kamilix2003/Band-pass-project/418358178_380706147782730_8515125975770715655_n.jpg

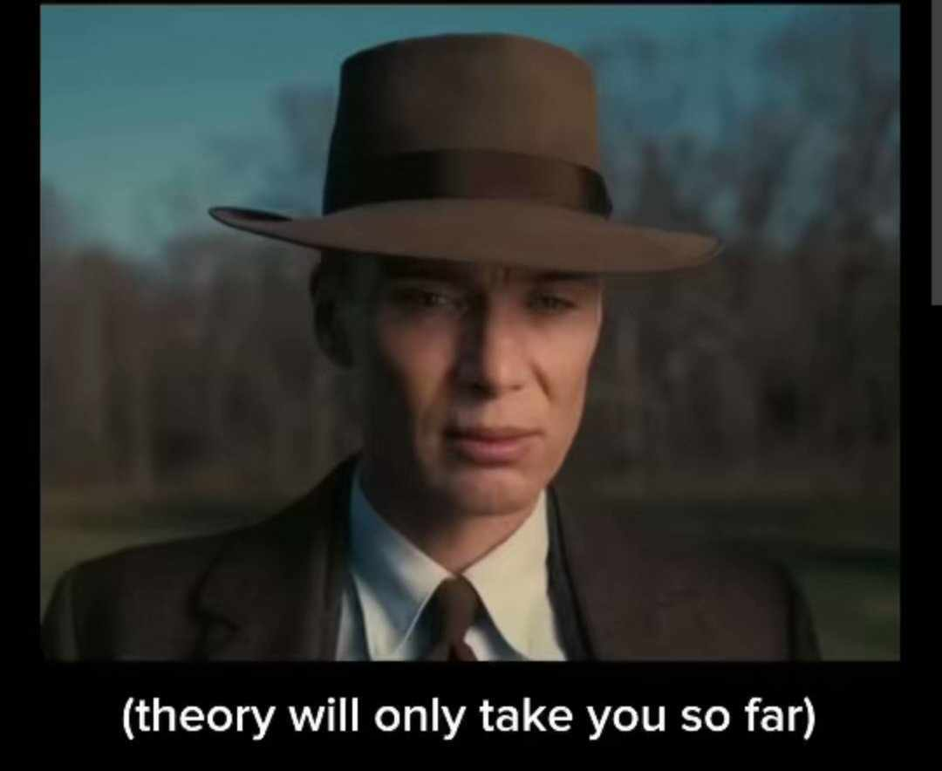
418358178_380706147782730_8515125975770715655_n.jpg
