kamilix2003/Band-pass-project/osc/RigolDS0.png

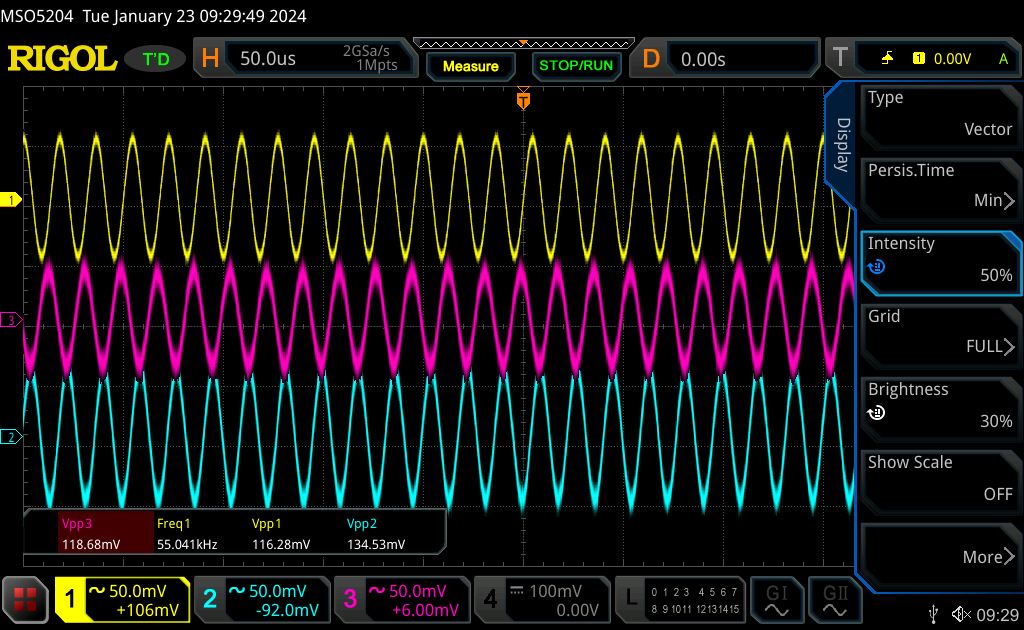
osc/RigolDS0.png
