kamilix2003/Band-pass-project/README.md

# Band-pass-project
Analogue Elelctronic Circuits I final project, op-amp based second order band pass filter with uni-polar power supply

[Project report](report.pdf)
