kamilix2003/Band-pass-project/filter-design-report-8.pdf

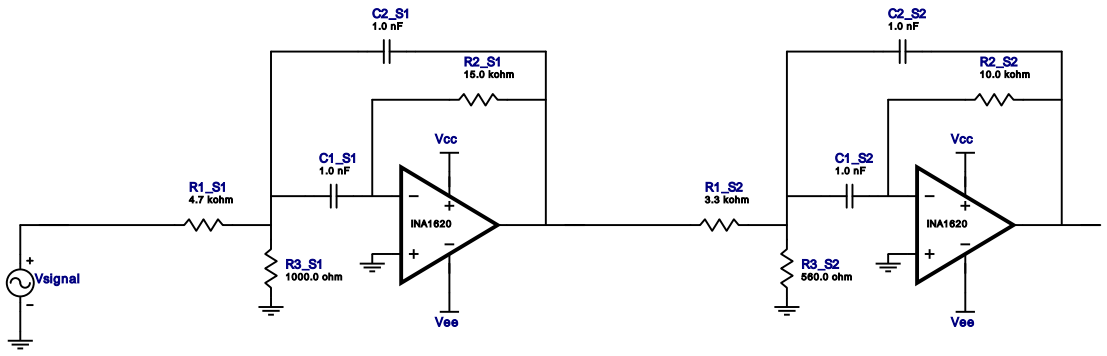
[picture p6: figure]
Vsignal; INA1620; R1_S1 4.7 kohm; R2_S1 15.0 kohm; R3_S1 1000.0 ohm; Vcc; Vee; R1_S2 3.3 kohm; R2_S2 10.0 kohm; R3_S2 560.0 ohm

Copyright © 2024, Texas Instruments Incorporated | 1
Filter Design Report | Bandpass Filter - 4th order Butterworth | January 16, 2024 07:32:41 GMT-06:00

## Filter Design Report

Design : Bandpass Filter - 4th order Butterworth Design ID: 8

Type : Bandpass
Response : Butterworth
Order : 4
Number of Stages : 2

## Electrical BOM

# Name | Manufacturer | Part Number | Properties | Qty

1. A1_S1 | Texas Instruments Inc. | INA1620 | GbwTyp= 32MHz VccMax= 36V VccMin= 4V | 1
2. A1_S2 | Texas Instruments Inc. | INA1620 | GbwTyp= 32MHz VccMax= 36V VccMin= 4V

1

3. C1_S1 | Generic | Ideal | Cap= 1.0 nF Tolerance= 2.0 %

1

4. C1_S2 | Generic | Ideal | Cap= 1.0 nF Tolerance= 2.0 %

1

5. C2_S1 | Generic | Ideal | Cap= 1.0 nF Tolerance= 2.0 %

1

6. C2_S2 | Generic | Ideal | Cap= 1.0 nF Tolerance= 2.0 %

1

7. R1_S1 | Generic | Ideal | Res= 4700.0ohm Tolerance= 10%

1

8. R1_S2 | Generic | Ideal | Res= 3300.0ohm Tolerance= 10%

1

9. R2_S1 | Generic | Ideal | Res= 15000.0ohm Tolerance= 10%

1

10. R2_S2 | Generic | Ideal | Res= 10000.0ohm Tolerance= 10%

1

11. R3_S1 | Generic | Ideal | Res= 1000.0ohm Tolerance= 10%

1

12. R3_S2 | Generic | Ideal | Res= 560.0ohm Tolerance= 10%

1

## Sensitivity Analysis

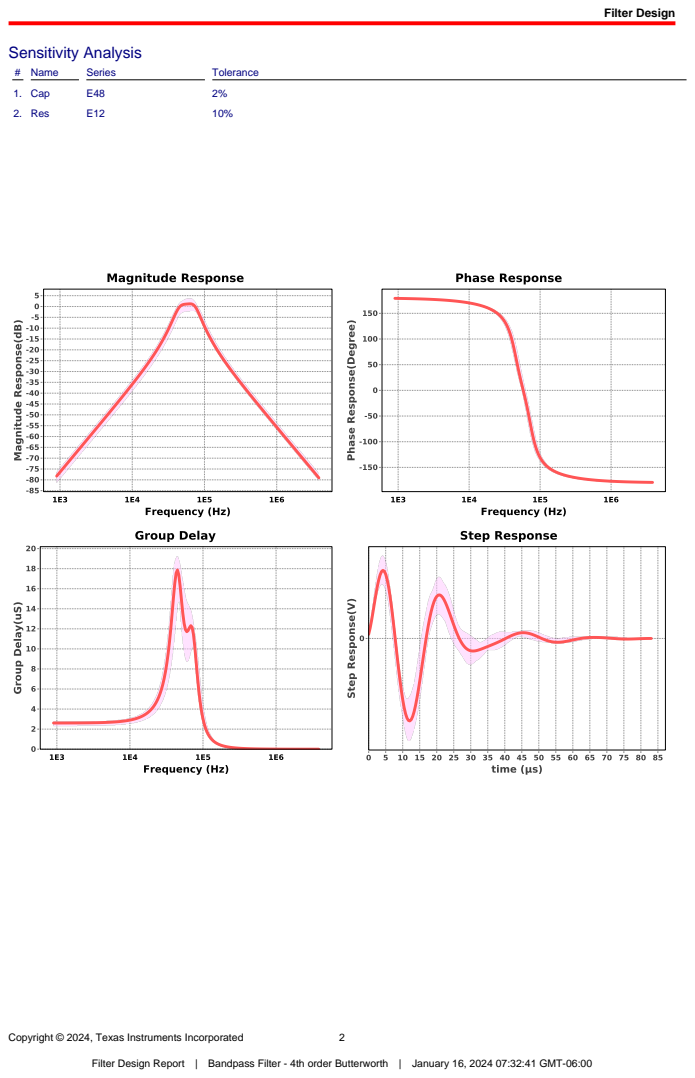
[picture p7: page 2]
Filter Design; # Name; Series; Tolerance; 1. Cap; 2. Res

## Design Inputs

# | Name | Value | Description

1. FilterType | bandpass
2. FilterResponse | Butterworth
3. FilterOrder | 4.0
4. FilterTopology | Multiple Feedback
5. NumberOfStages | 2.0
6. CenterFrequency | 60.0 k
7. StopbandAttenuation | -40.001
8. PassbandBandwidth | 40.0 k
9. StopbandBandwidth | 400.0 k
10. Gain | 1.0
11. SingleSupply | 15.0 | Power supply(s) to active chips
12. ResistorTolerance | E12 | Resistor series - 10% Passive resistor tolerance
13. CapacitorTolerance | E48 | Capacitor series - 2% Passive capacitor tolerance

## Design Assistance

1. INA1620 Product Folder : http://www.ti.com/product/INA1620 : contains the data sheet and other resources.

# Filter Stage :1

Cutoff Frequency | 45.255 kHz
Min GBW Reqd | 14.992 MHz
Stage Gain | 1.596 V/V
Stage Q | 2.133
Stage Topology | Multiple Feedback

C2_S1
1.0 nF

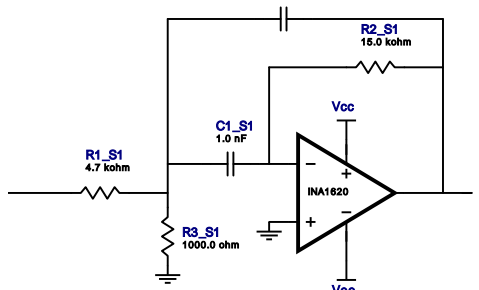
[picture p8: figure]
INA1620; R1_S1 4.7 kohm; R2_S1 15.0 kohm; R3_S1 1000.0 ohm; Vcc

Vee

## Electrical BOM

# Name | Manufacturer | Part Number | Properties | Qty

1. A1_S1 | Texas Instruments Inc. | INA1620 | GbwTyp= 32MHz VccMax= 36V VccMin= 4V | 1
2. C1_S1 | Generic | Ideal | Cap= 1.0 nF Tolerance= 2.0 %

1

3. C2_S1 | Generic | Ideal | Cap= 1.0 nF Tolerance= 2.0 %

1

4. R1_S1 | Generic | Ideal | Res= 4700.0ohm Tolerance= 10%

1

5. R2_S1 | Generic | Ideal | Res= 15000.0ohm Tolerance= 10%

1

6. R3_S1 | Generic | Ideal | Res= 1000.0ohm Tolerance= 10%

1

# Filter Stage :2

Cutoff Frequency | 72.738 kHz
Min GBW Reqd | 24.22 MHz
Stage Gain | 1.515 V/V
Stage Q | 2.285
Stage Topology | Multiple Feedback

C2_S2
1.0 nF

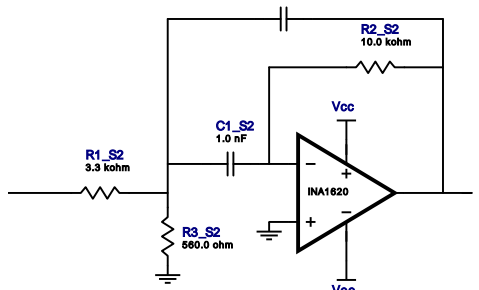
[picture p9: figure]
INA1620; R1_S2 3.3 kohm; R2_S2 10.0 kohm; R3_S2 560.0 ohm; Vcc

Vee

## Electrical BOM

# Name | Manufacturer | Part Number | Properties | Qty

1. A1_S2 | Texas Instruments Inc. | INA1620 | GbwTyp= 32MHz VccMax= 36V VccMin= 4V | 1
2. C1_S2 | Generic | Ideal | Cap= 1.0 nF Tolerance= 2.0 %

1

3. C2_S2 | Generic | Ideal | Cap= 1.0 nF Tolerance= 2.0 %

1

4. R1_S2 | Generic | Ideal | Res= 3300.0ohm Tolerance= 10%

1

5. R2_S2 | Generic | Ideal | Res= 10000.0ohm Tolerance= 10%

1

6. R3_S2 | Generic | Ideal | Res= 560.0ohm Tolerance= 10%

1

Important Notice and Disclaimer

TI provides technical and reliability data (including datasheets), design resources (including reference designs), application or other design advice, web tools, safety information, and other resources AS IS and with all faults, and disclaims all warranties. These resources are intended for skilled developers designing with TI products. You are solely responsible for (1) selecting the appropriate TI products for your application, (2) designing, validating and testing your application, and (3) ensuring your application meets applicable standards, and any other safety, security, or other requirements.

These resources are subject to change without notice. TI grants you permission to use these resources only for development of an application that uses the TI products described in the resource. Other reproduction and display of these resources is prohibited. No license is granted to any other TI intellectual property right or to any third party intellectual property right. TI disclaims responsibility for, and you will fully indemnify TI and its representatives against, any claims, damages, costs, losses, and liabilities arising out of your use of these resources.

Providing these resources does not expand or otherwise alter TI's applicable Terms of Sale or other applicable terms available either on ti.com or provided in conjunction with TI products.
