kamilix2003/Band-pass-project/osc/RigolDS2.png

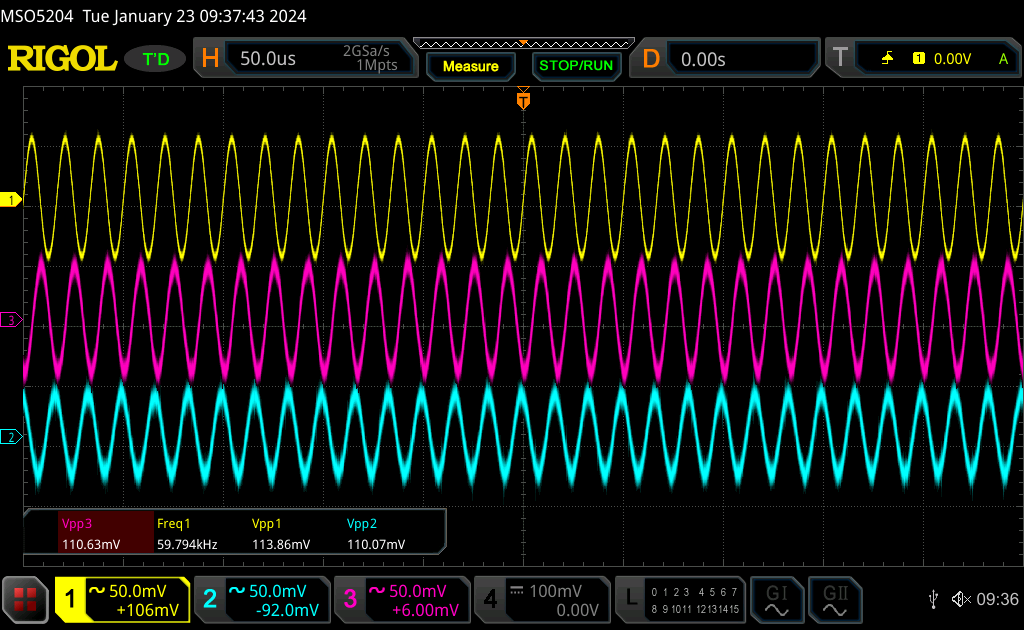
osc/RigolDS2.png
