kamilix2003/Band-pass-project/osc/RigolDS3.png

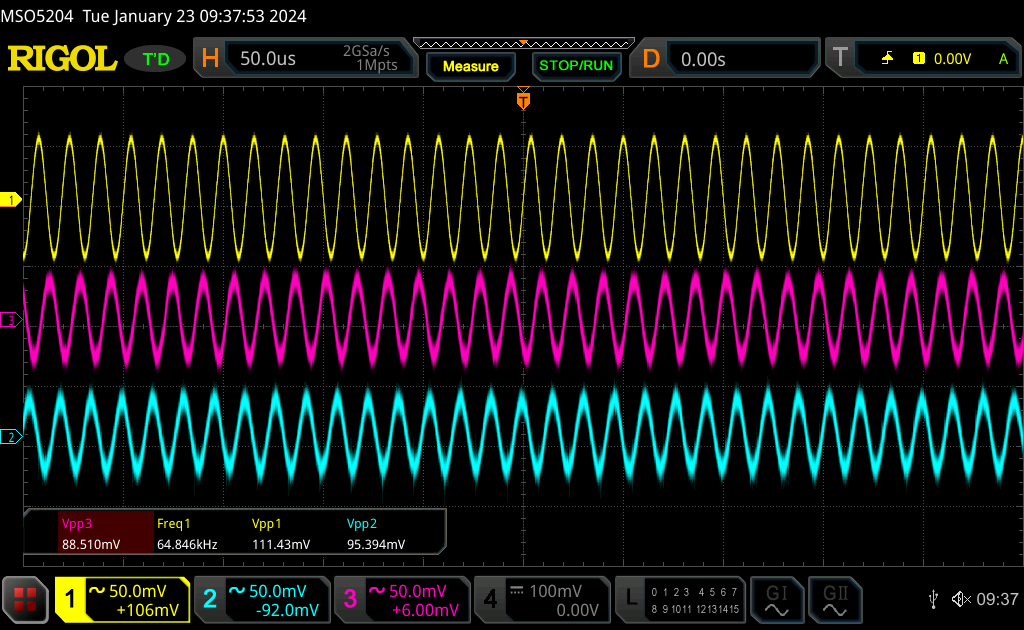
osc/RigolDS3.png
