kamilix2003/Band-pass-project/osc/RigolDS4.png

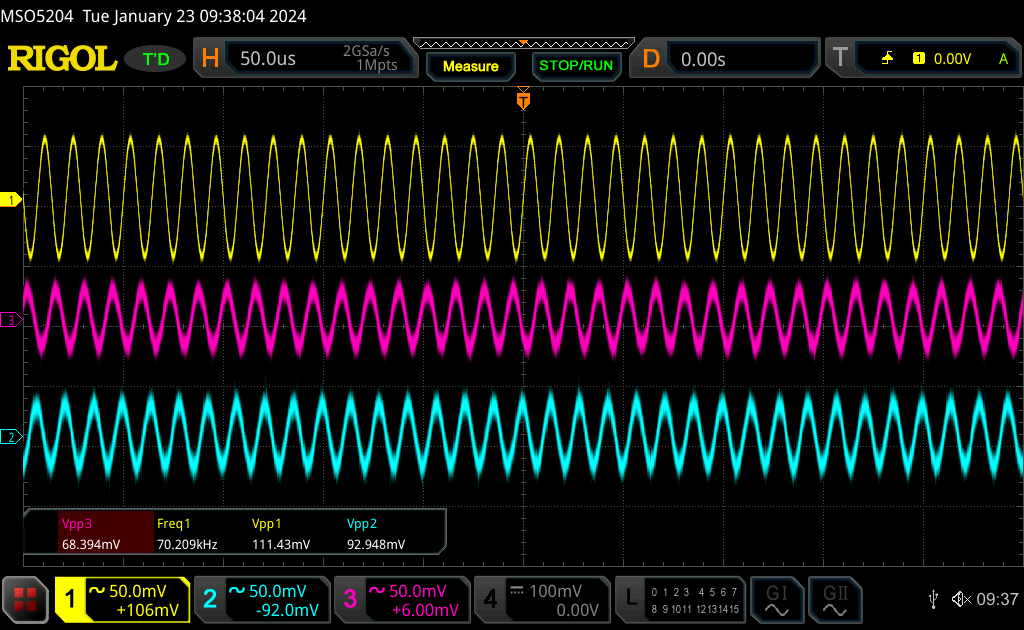
osc/RigolDS4.png
