kamilix2003/Band-pass-project/osc/RigolDS5.png

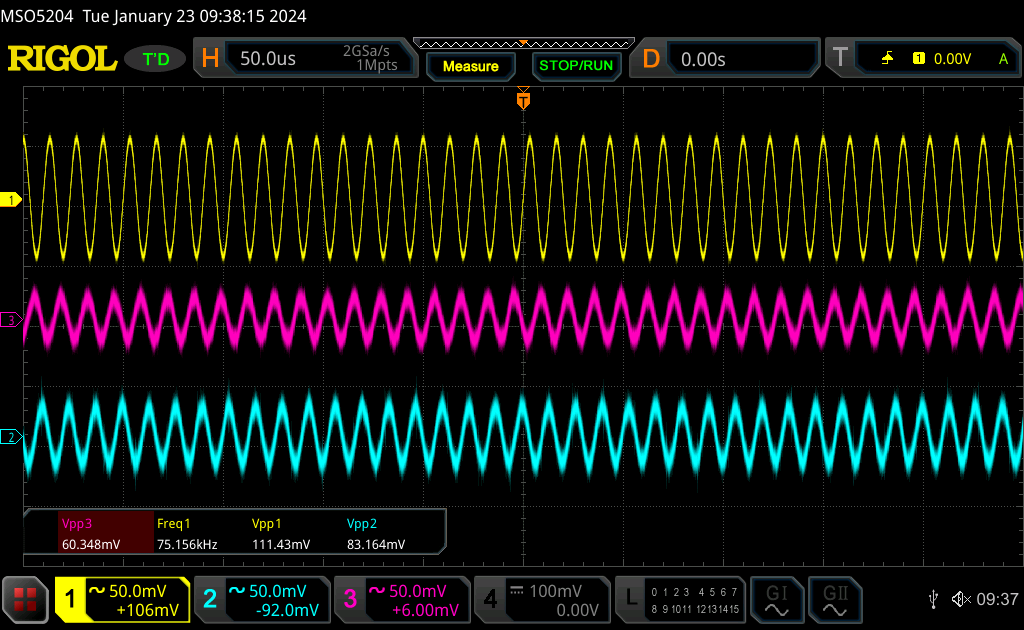
osc/RigolDS5.png
