kamilix2003/Band-pass-project/osc/RigolDS6.png

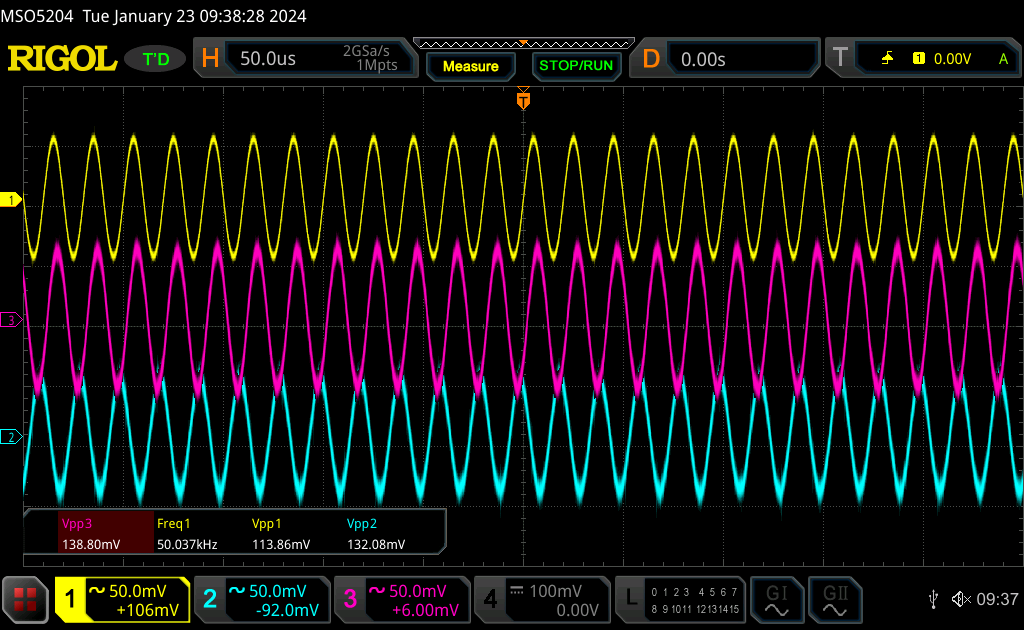
osc/RigolDS6.png
