kamilix2003/Band-pass-project/osc/RigolDS7.png

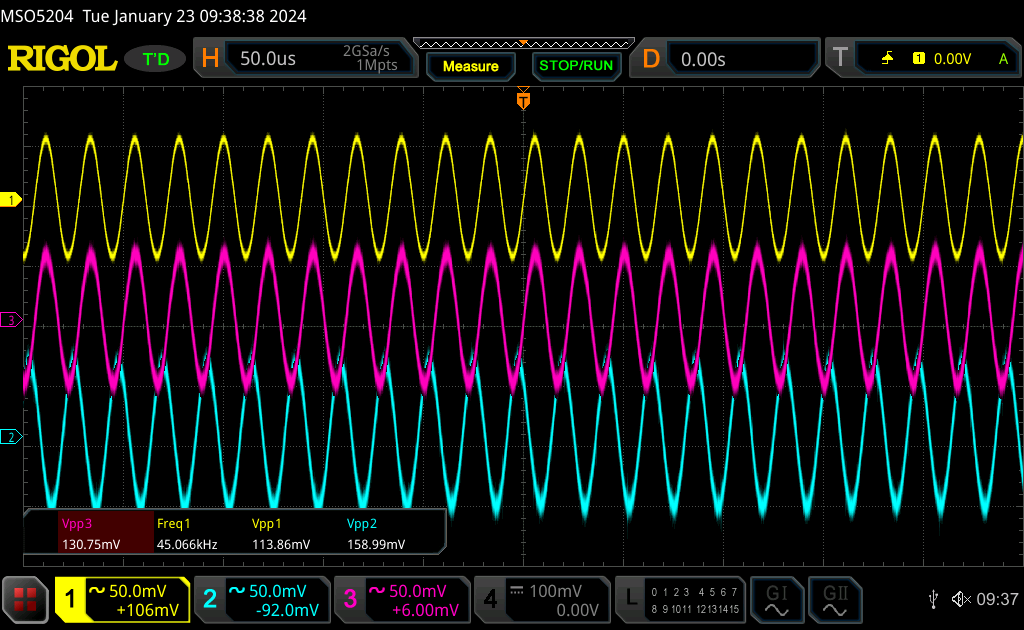
osc/RigolDS7.png
