kamilix2003/Band-pass-project/osc/RigolDS8.png

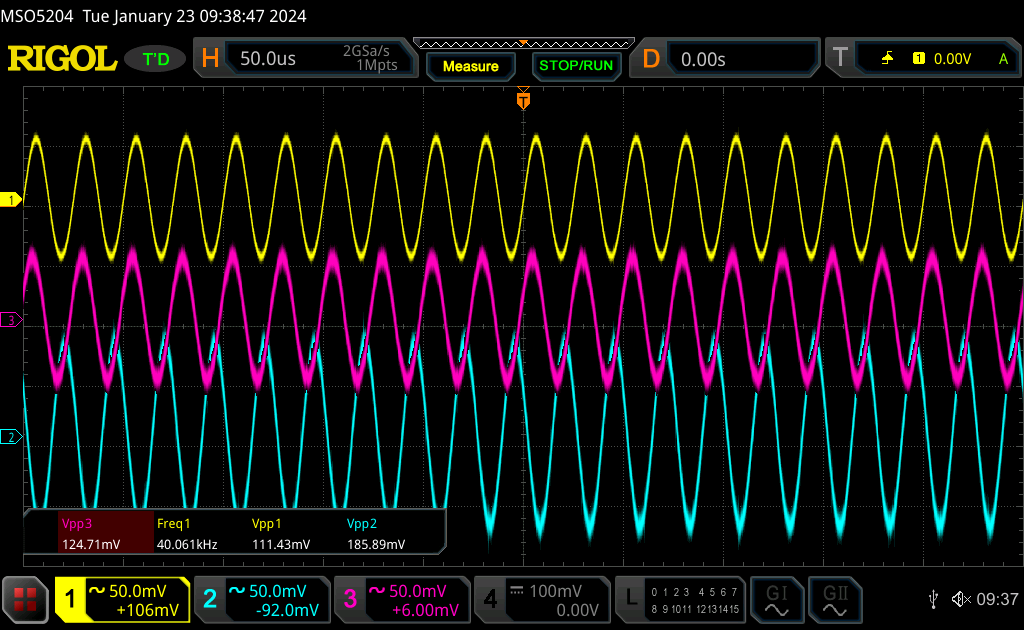
osc/RigolDS8.png
