kamilix2003/Band-pass-project/osc/RigolDS9.png

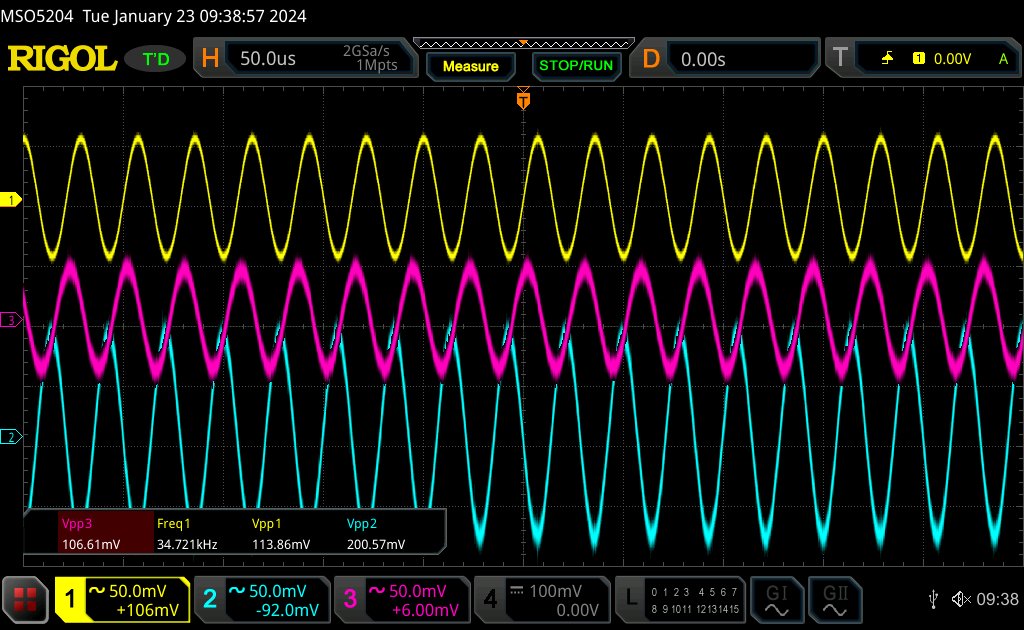
osc/RigolDS9.png
