kamilix2003/Band-pass-project/osc/RigolDS10.png

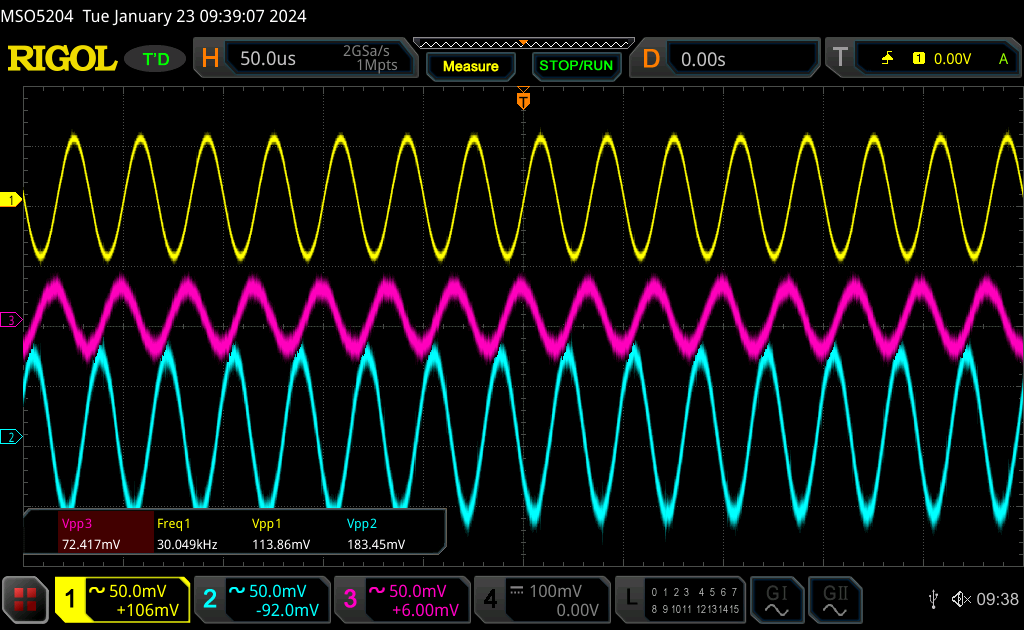
osc/RigolDS10.png
