kamilix2003/Band-pass-project/osc/RigolDS11.png

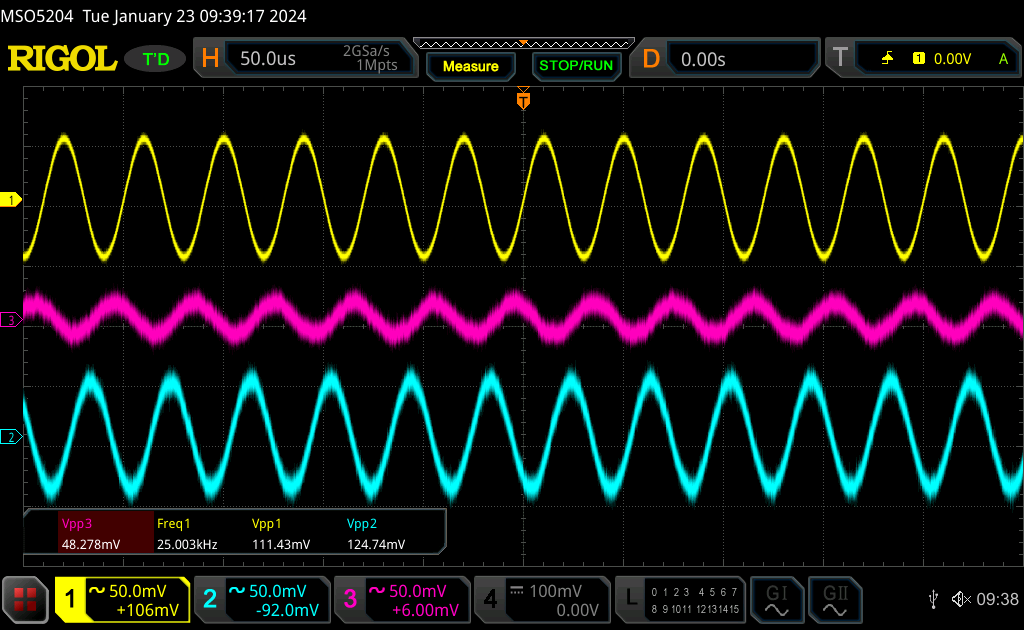
osc/RigolDS11.png
