kamilix2003/Band-pass-project/osc/RigolDS12.png

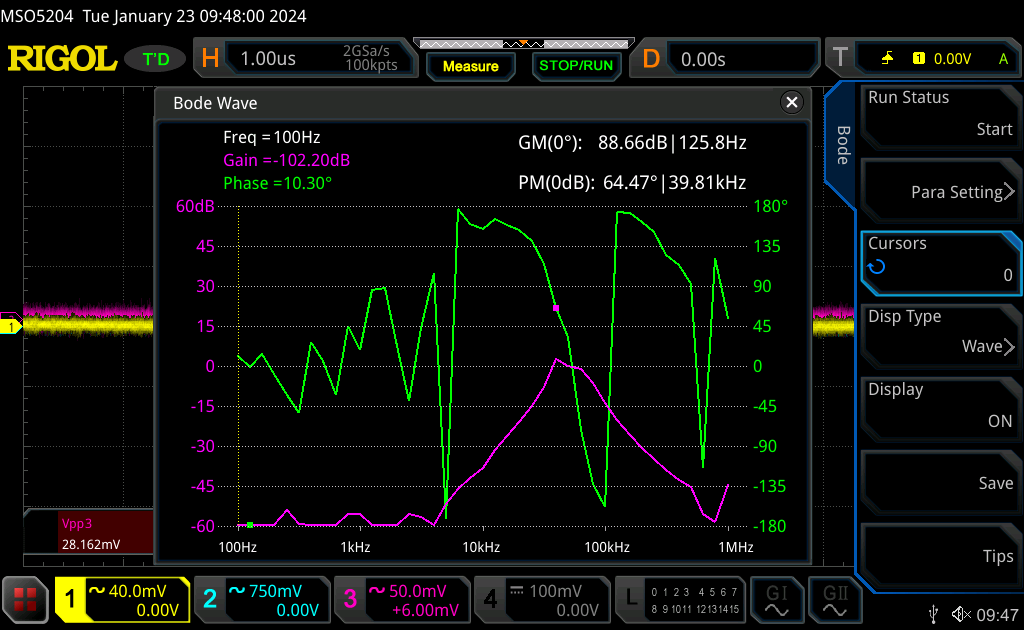
osc/RigolDS12.png
