kamilix2003/Band-pass-project/osc/RigolDS13.png

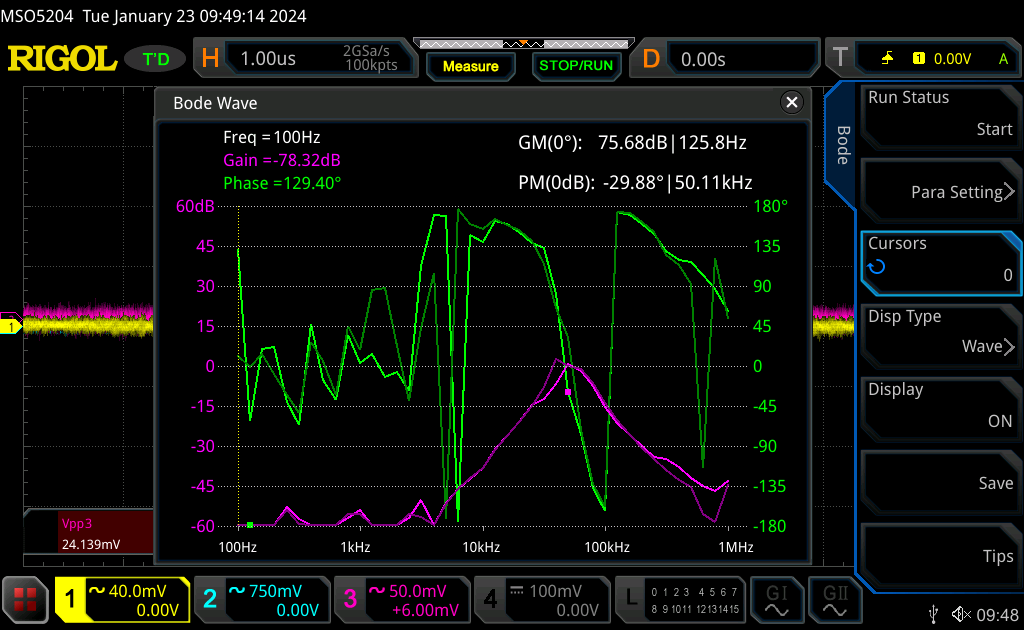
osc/RigolDS13.png
