kamilix2003/Band-pass-project/LTspice/clean_circuit.asc

C1: cap; 1n
C2: cap; 1n
C3: cap; 1n
C4: cap; 1n
R1: res; 15k
R2: res; 4.7k
R3: res; 1k
R4: res; 10k
R5: res; 3.3k
R6: res; 560
U1: opamp2; LM324
U2: opamp2; LM324
Named nets: 0, Vcc, out2, out1, ref, A, B, 1-, 2-, in
