kamilix2003/Band-pass-project/LTspice/MFB_topology.asc

C1: cap
C2: cap
R1: res
R2: res
R3: res
U1: opamp2; LM324
Named nets: Vcc, 0, OUT, IN, ref
