kamilix2003/Band-pass-project/measurement.xlsx

freq | CH1 | CH2 | CH3 | gain stage 1 | gain stage 2
25003 | 0.11143 | 0.12474 | 0.048278 | 1.119447187 | 0.433258548 | 0.0490036092 | -0.3632528601
30049 | 0.11387 | 0.18345 | 0.072417 | 1.611047686 | 0.635962062 | 0.2071083954 | -0.1965687912
34721 | 0.11386 | 0.20057 | 0.10661 | 1.761549271 | 0.9363253118 | 0.245894795 | -0.02857323613
40063 | 0.11143 | 0.18589 | 0.12471 | 1.668222202 | 1.119177959 | 0.2222538969 | 0.04889914871
45066 | 0.11387 | 0.15899 | 0.13075 | 1.396241328 | 1.14823922 | 0.1449604887 | 0.06003237689
50037 | 0.11387 | 0.13208 | 0.1388 | 1.159919206 | 1.218933872 | 0.0644277396 | 0.08598014547
55131 | 0.11387 | 0.11985 | 0.12069 | 1.052516027 | 1.05989286 | 0.02222871772 | 0.02526196664
59694 | 0.11386 | 0.11007 | 0.11063 | 0.9667135078 | 0.9716318286 | -0.014702213 | -0.01249826708
64846 | 0.11143 | 0.095394 | 0.08851 | 0.8560890245 | 0.7943103294 | -0.06748107079 | -0.1000097898
70209 | 0.11143 | 0.092948 | 0.068394 | 0.8341380239 | 0.6137844387 | -0.0787620812 | -0.2119841265
